marcorispoli/PCB301/(list of files, cad)

Other CAD files:
ESECUTIVI/PM22-301-0.dwg
LAYOUT/22-301-0.dwg
ESECUTIVI/PF22-301-0.dwg
ESECUTIVI/22-301-0.dwg
