marcorispoli/PCB301/ORCAD/SCH_301-0.pdf

0

0

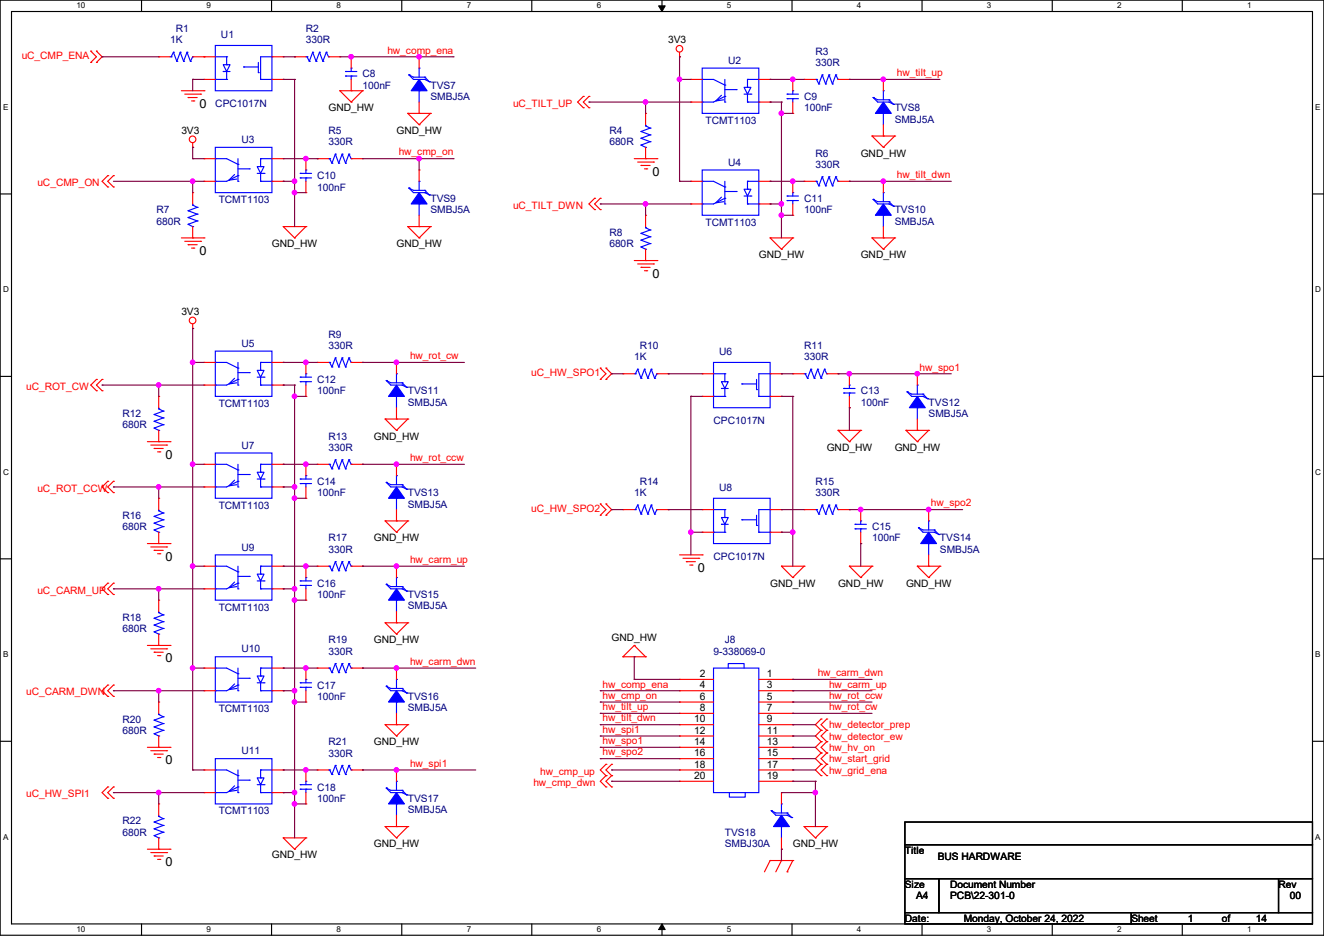
[picture p1: page 1]

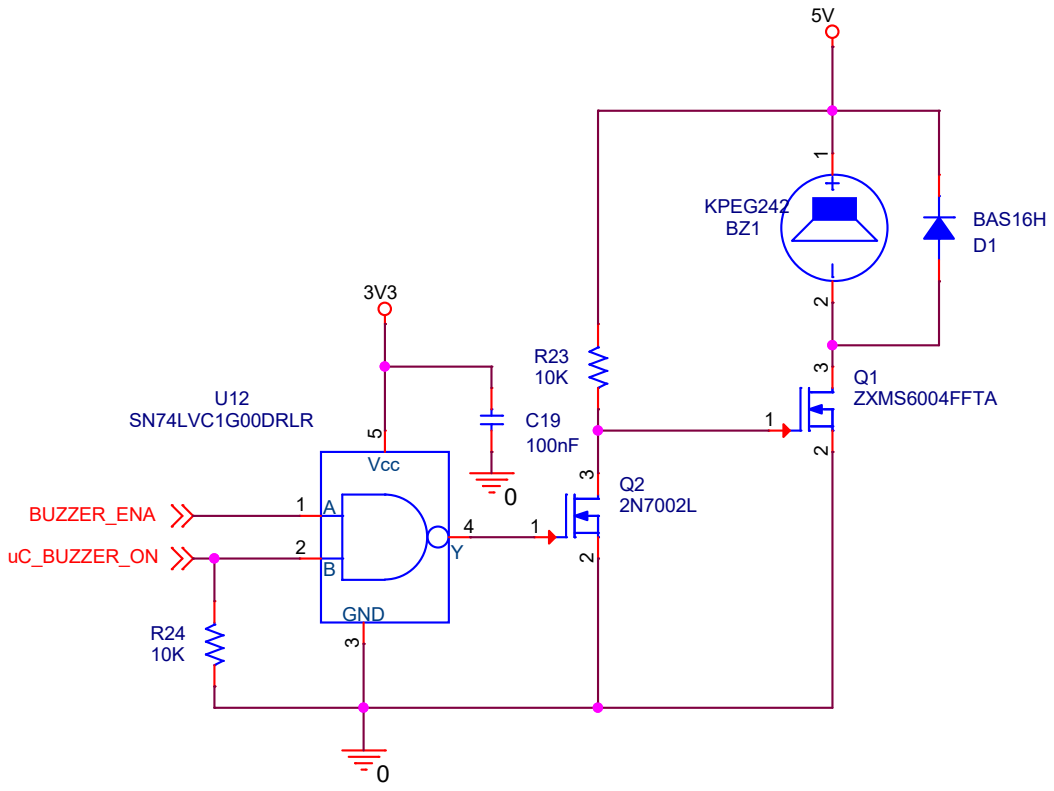
[picture p2: page 2]
BUZZER_ENA; uC_BUZZER_ON; Title; BUZZER; Monday, October 24, 2022; U12 SN74LVC1G00DRLR; 3 GND; Vcc⁵; ZXMS6004FFTA; BAS16H; KPEG242

0

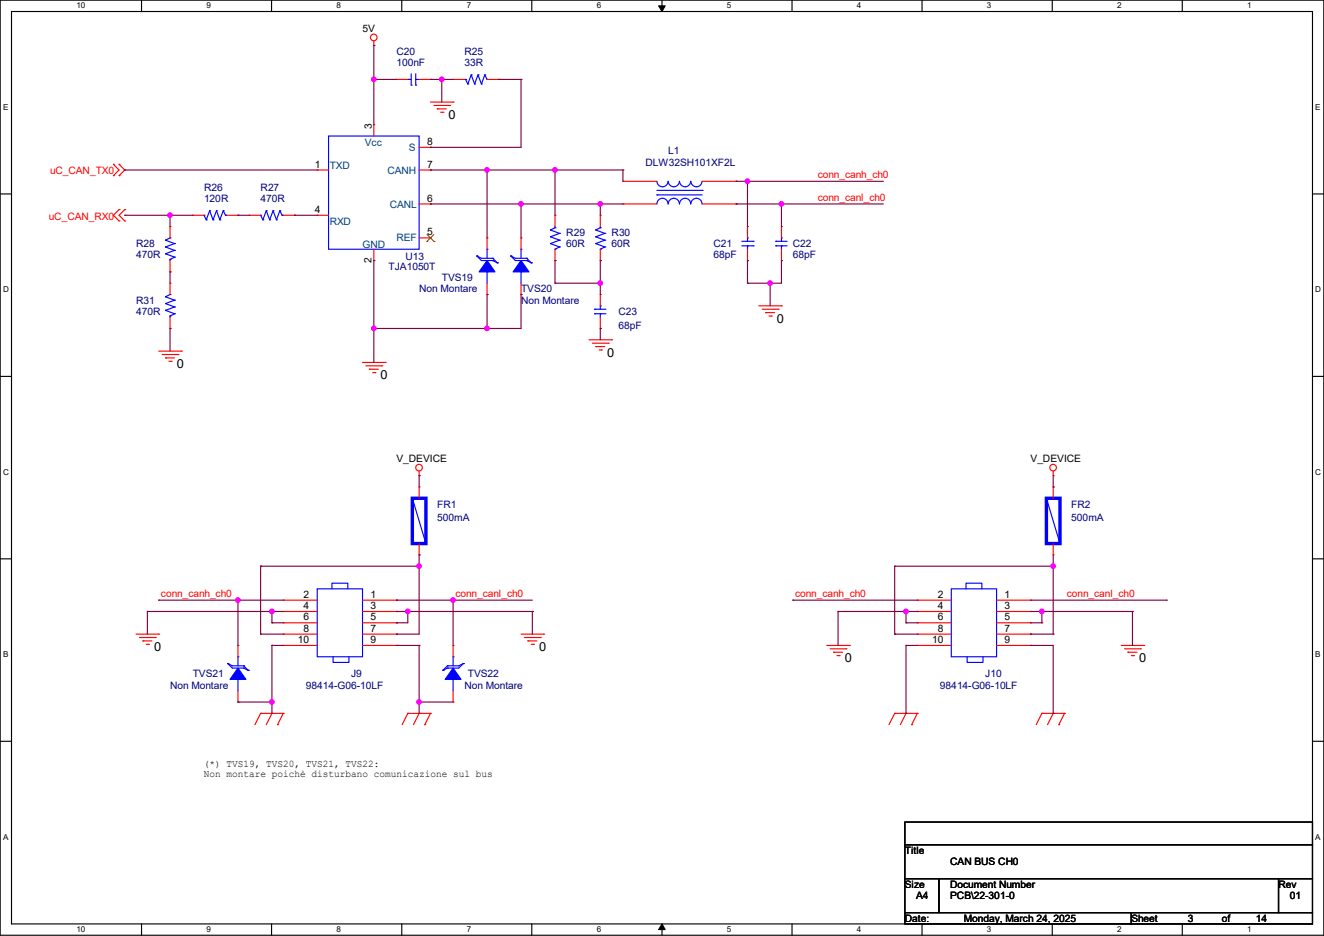
[picture p3: page 3]

Non montare poichè disturbano comunicazione sul bus

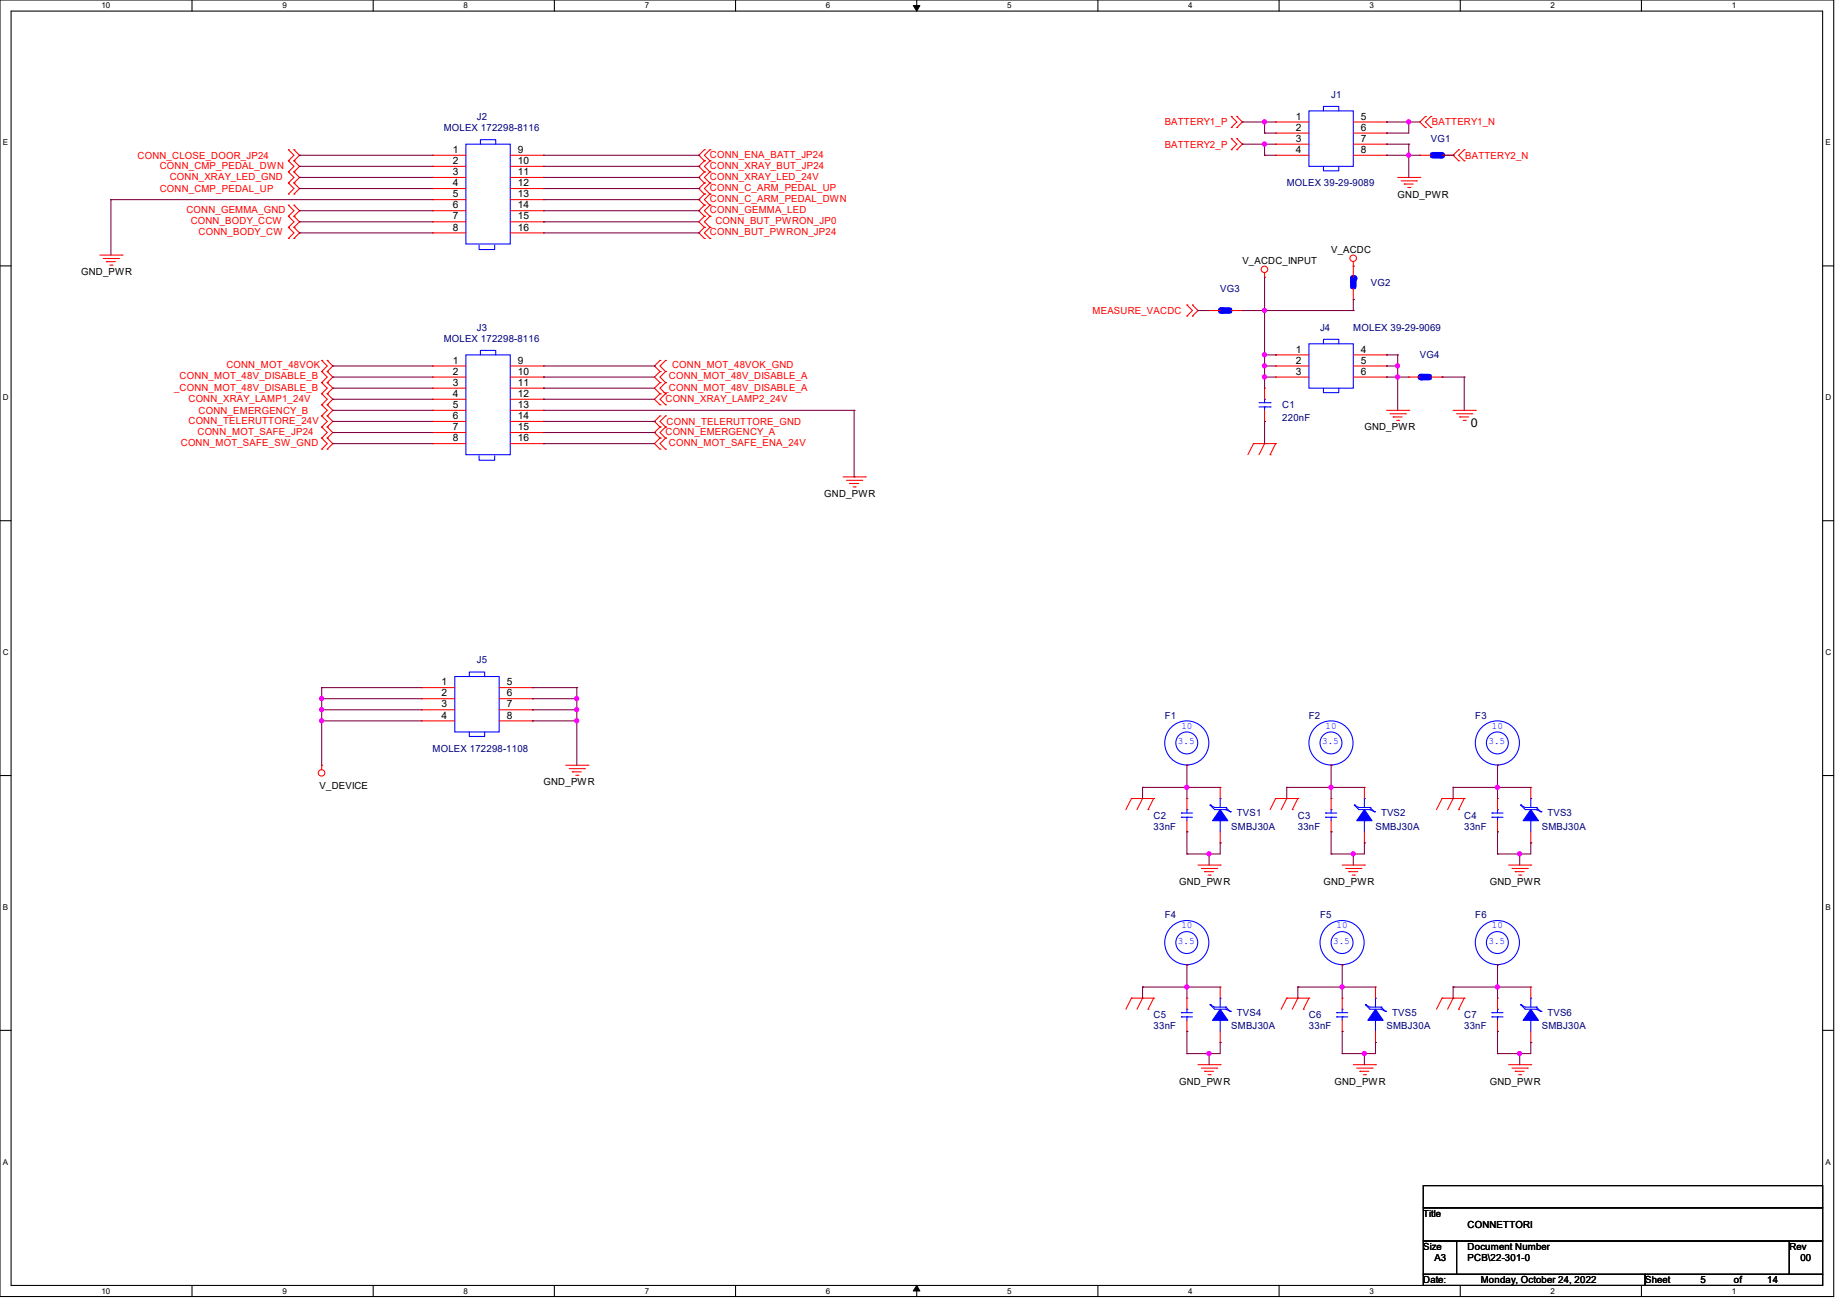
[picture p4: page 4]

0

det_ew prep | hv_on | start_grid | grid_ena | det_ew

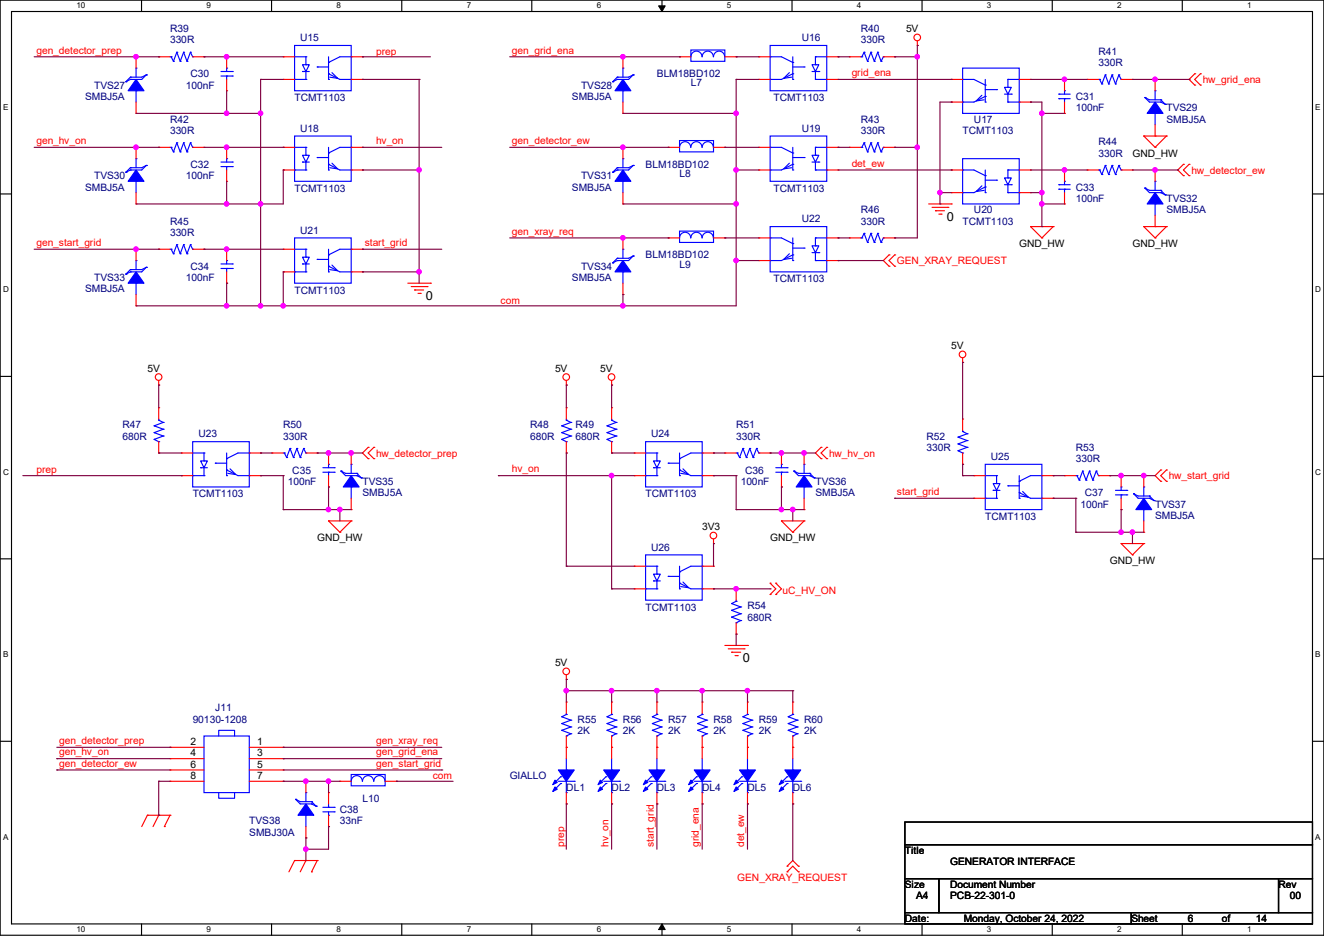
[picture p5: page 5]

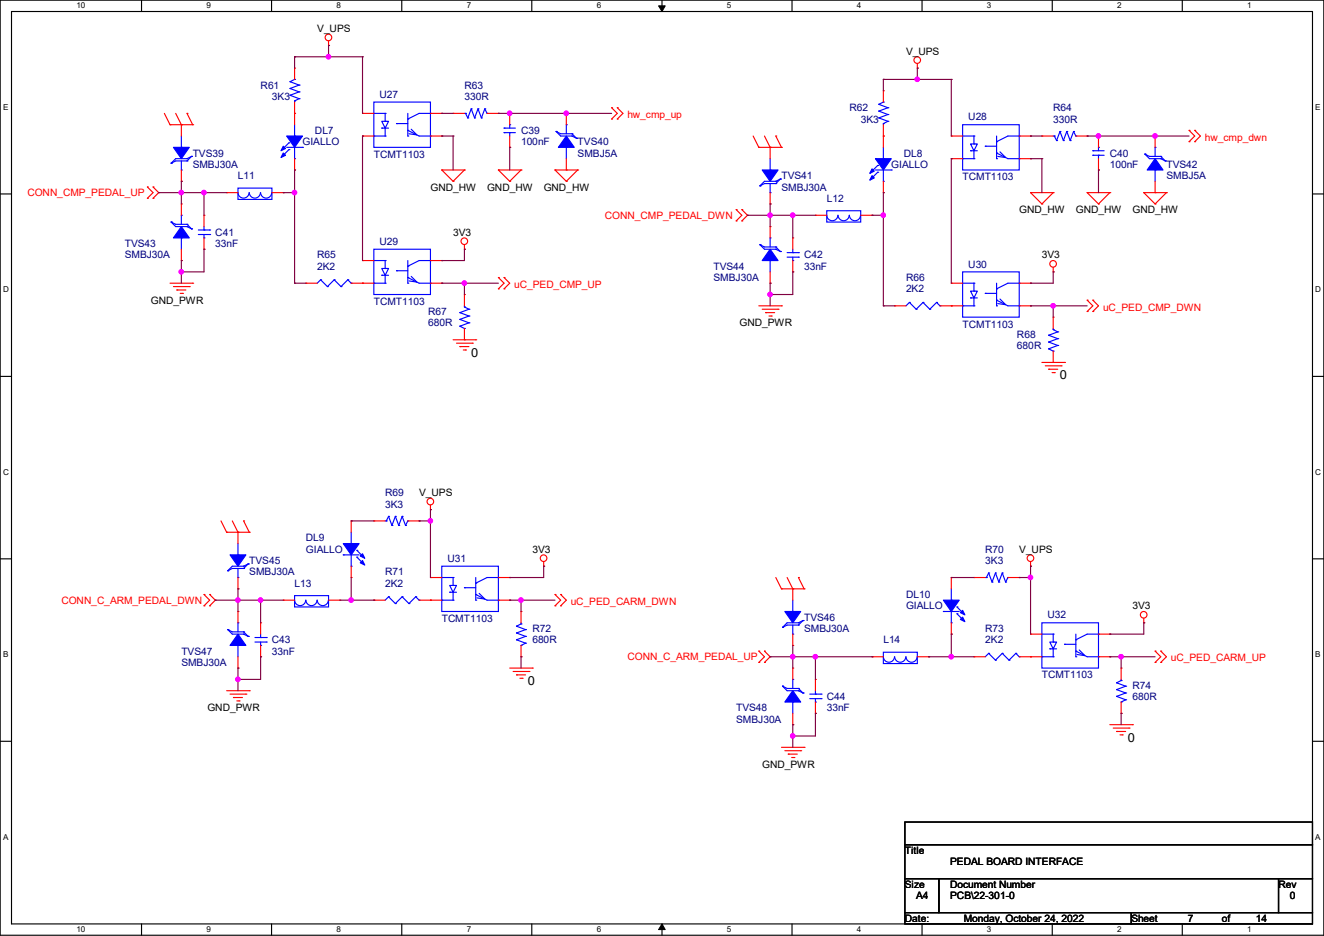
[picture p6: page 6]

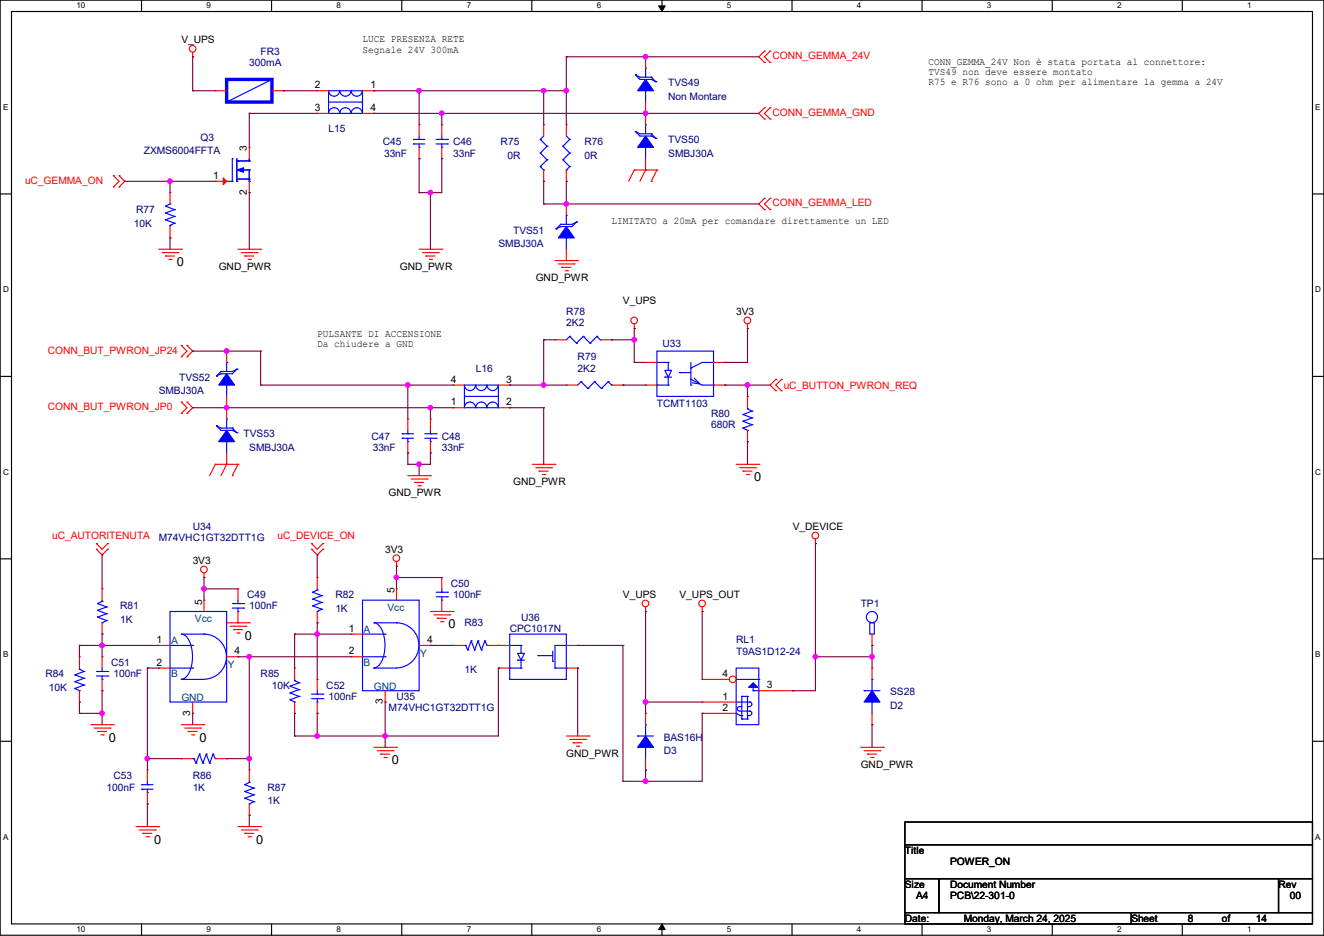
[picture p7: page 7]

CONN_GEMMA_24V Non è stata portata al connettore:
TVS49 non deve essere montato
R75 e R76 sono a 0 ohm per alimentare la gemma a 24V

LIMITATO a 20mA per comandare direttamente un LED

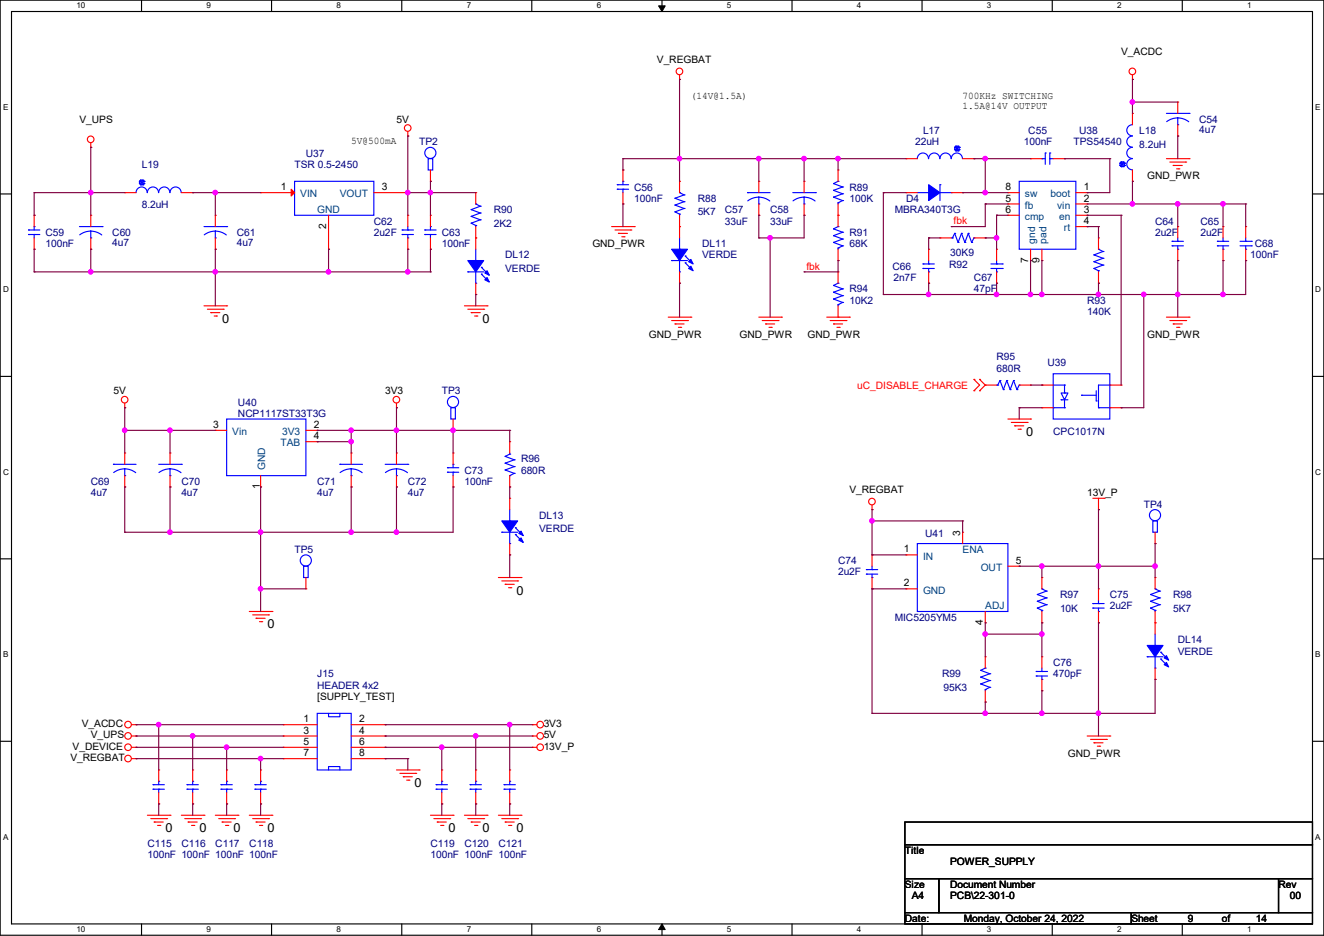
[picture p8: page 8]

0

0

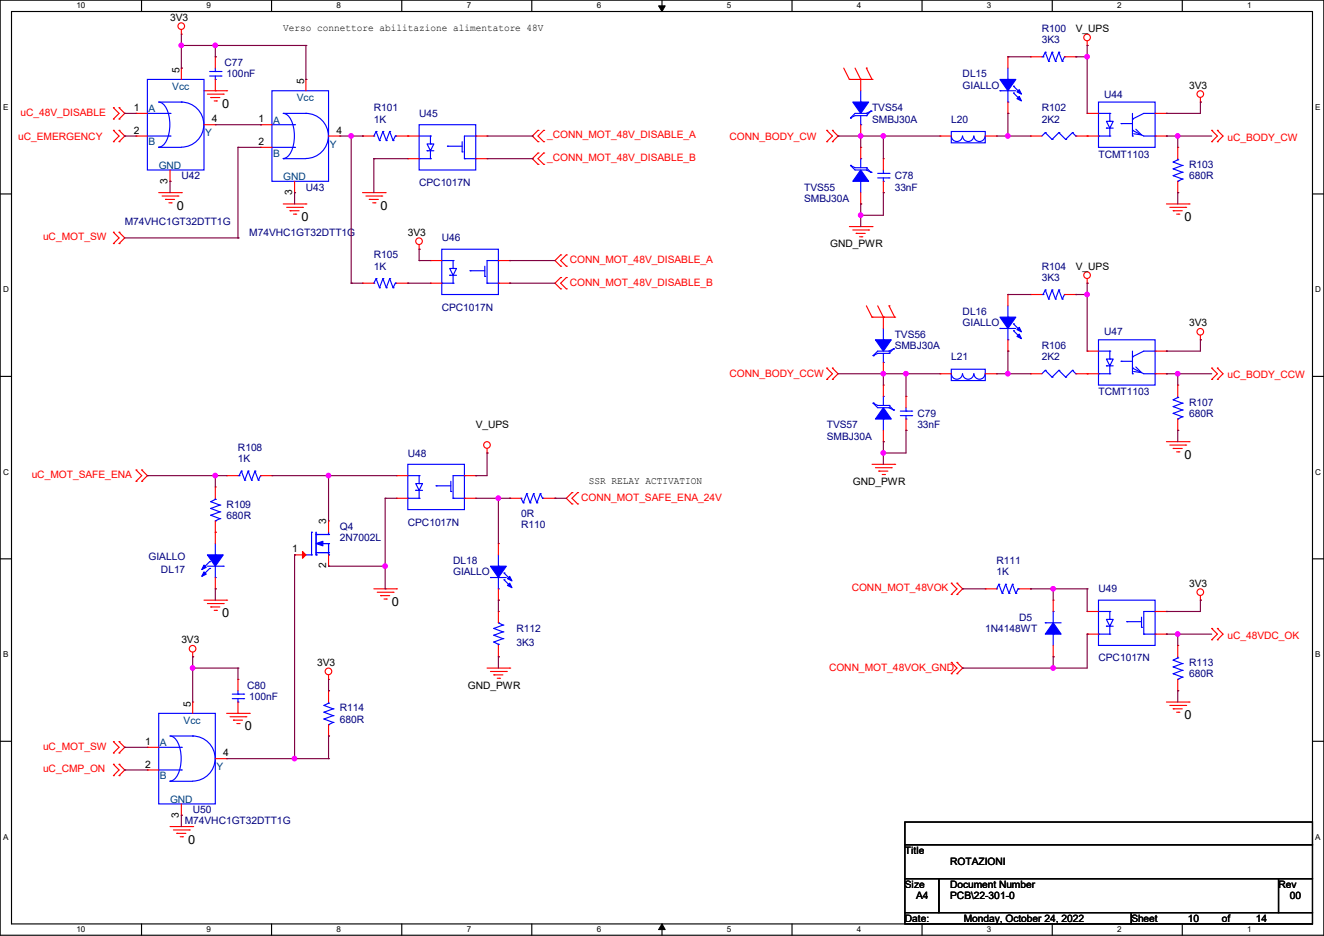
[picture p9: page 9]

Verso connettore abilitazione alimentatore 48V

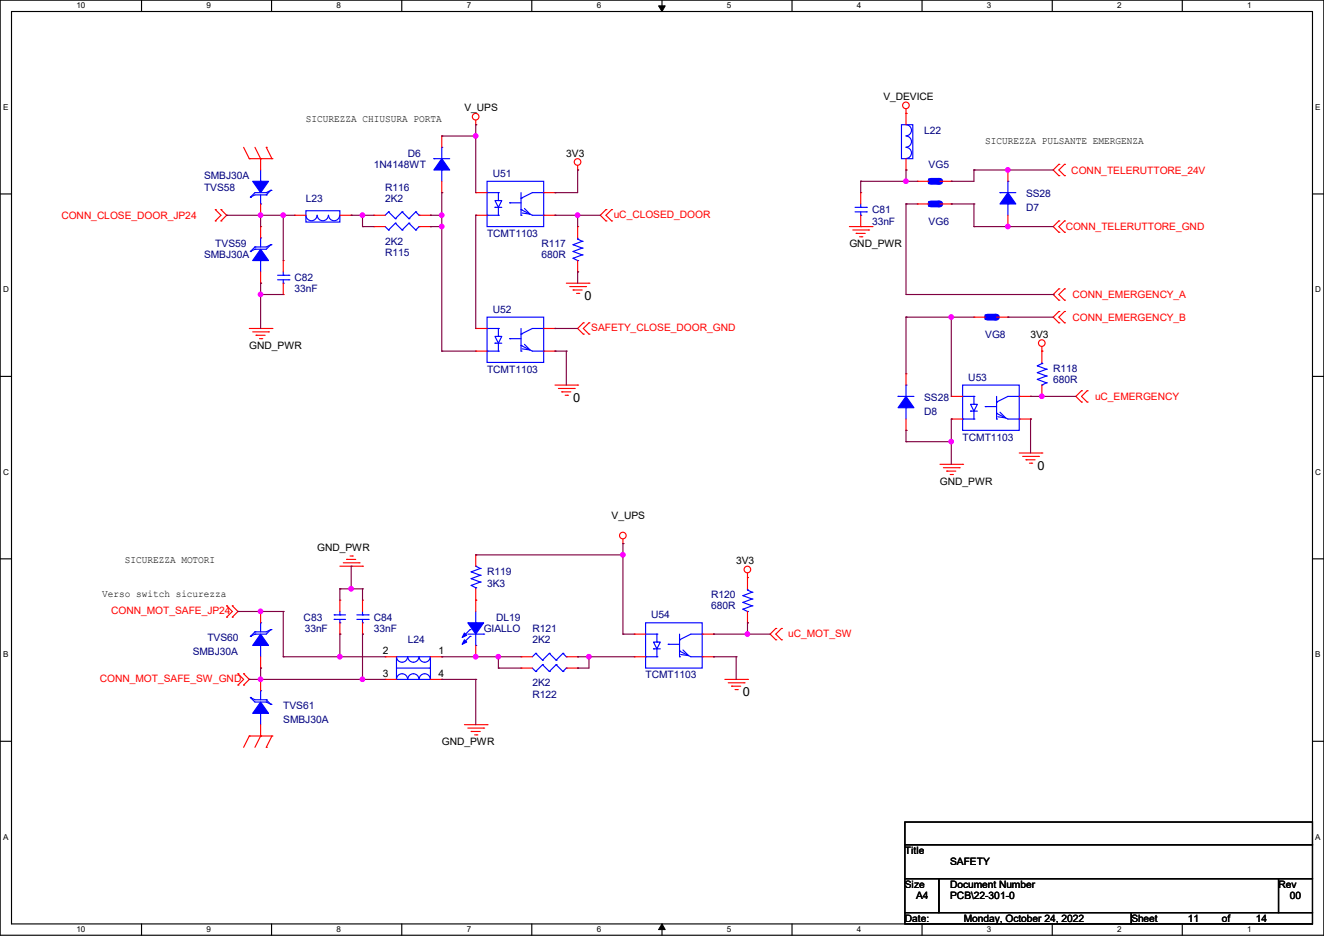
[picture p10: page 10]

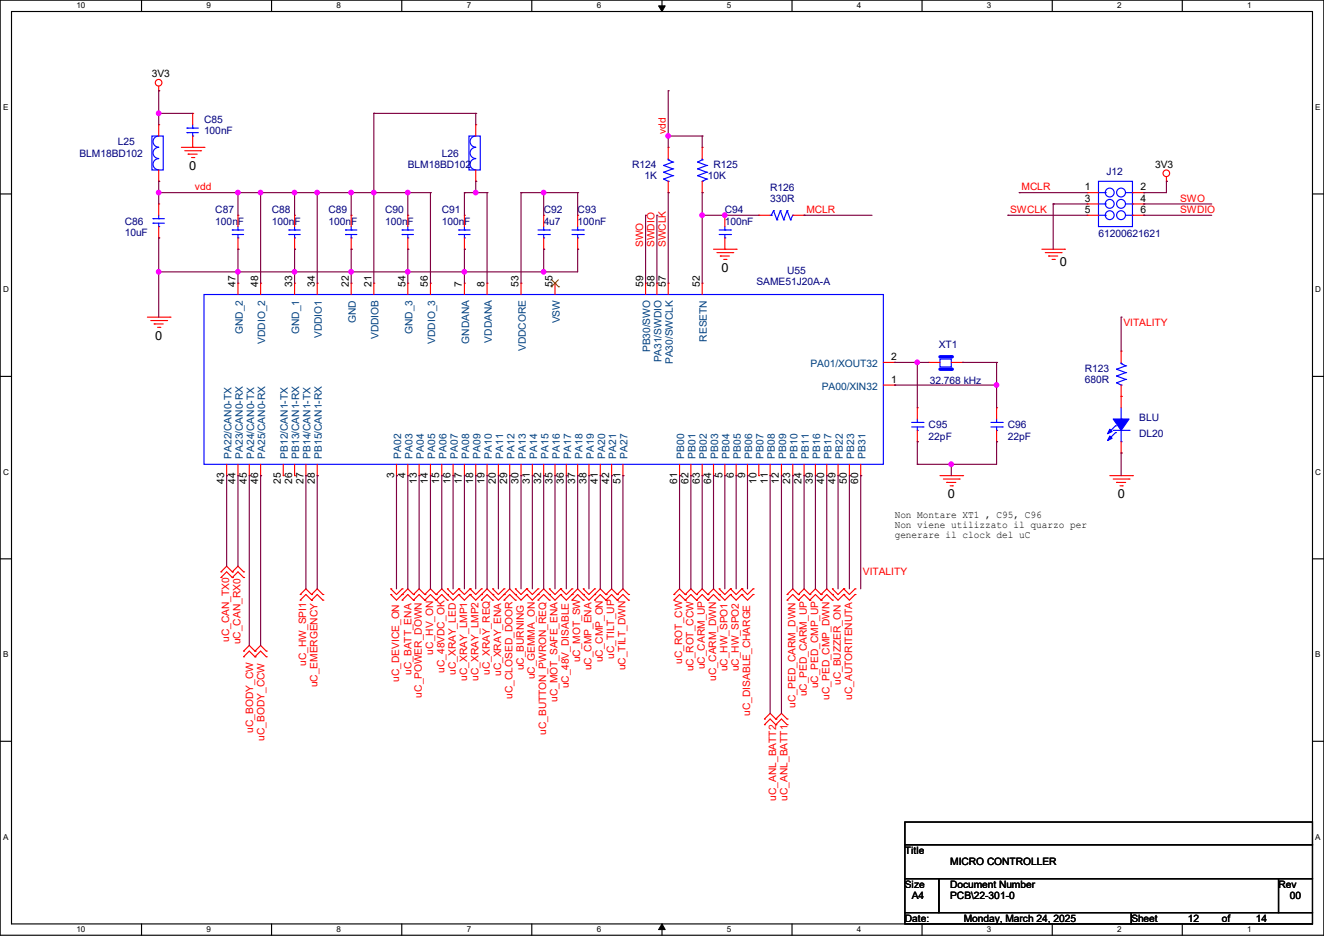
[picture p11: page 11]

9 PB07 10 PB08 11 PB09 12 PA04 13 PA05 14 PA06 15 PA07 16 PA08 17 PA09 18 PA10 19 PA11 20 VDDIOB 21 GND 22 PB10 23 PB11 24 PB12/CAN1-TX 25 PB13/CAN1-RX 26 PB14/CAN1-TX 27 PB15/CAN1-RX 28 PA12 29 PA13 30 PA14 31 PA15 32 GND_1 33 VDDIO1 34 PA16 35 PA17 36 PA18 37 PA19 38 PB16 39 PB17 40 PA20 41 PA21 42 PA22/CAN0-TX 43 PA23/CAN0-RX 44 PA24/CAN0-TX 45 PA25/CAN0-RX 46 GND_2 47 VDDIO_2 48 PB22 49 PB23 50 PA27 51 RESETN 52 VDDCORE 53 GND_3 54 VSW 55 VDDIO_3 56 PA30/SWCLK 57 PA31/SWDIO 58 PB30/SWO 59 PB31 60 PB00 61 PB01 62 PB02 63 PB03 64

Non Montare XT1 , C95, C96
Non viene utilizzato il quarzo per
generare il clock del uC

# 25A 500mA

25A 25A

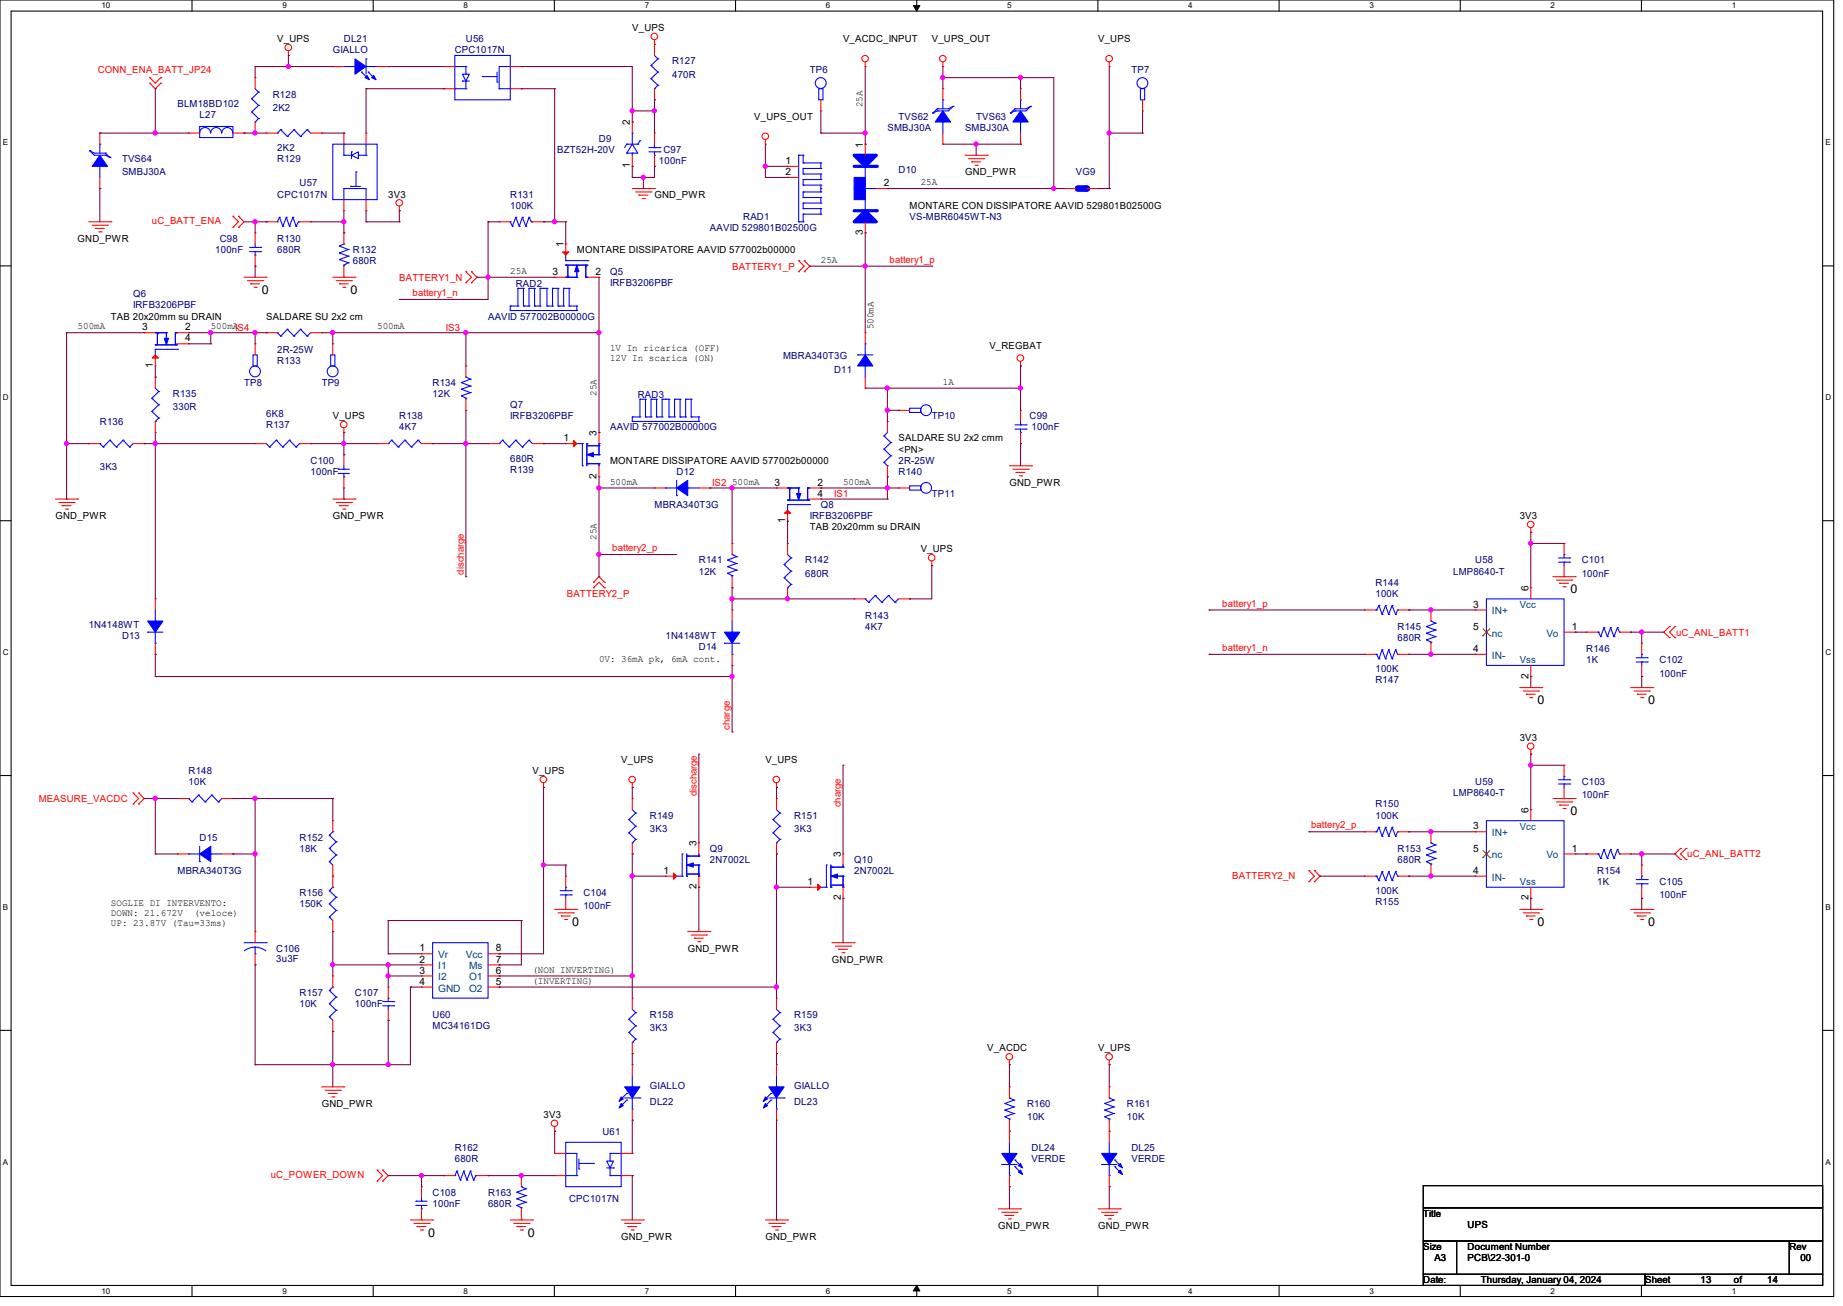
[picture p12: page 12]

D10VS-MBR6045WT-N3 MONTARE CON DISSIPATORE AAVID 529801B02500G

<PN> SALDARE SU 2x2 cmm

0

0

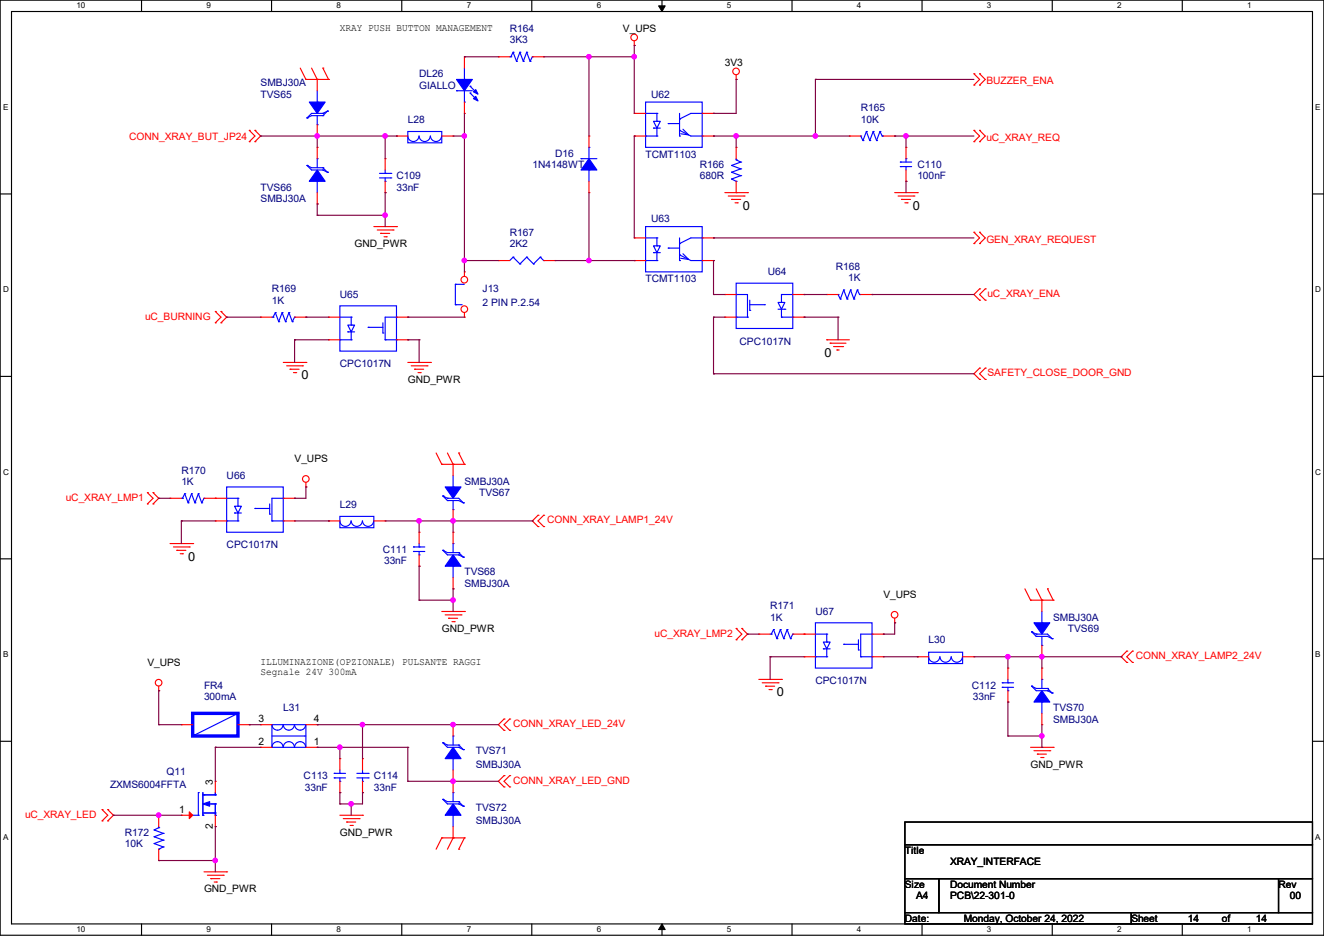
[picture p13: page 13]

XRAY PUSH BUTTON MANAGEMENT

ILLUMINAZIONE(OPZIONALE) PULSANTE RAGGI
Segnale 24V 300mA
