marcorispoli/PCB301/ESECUTIVI/PF22-301-0.pdf

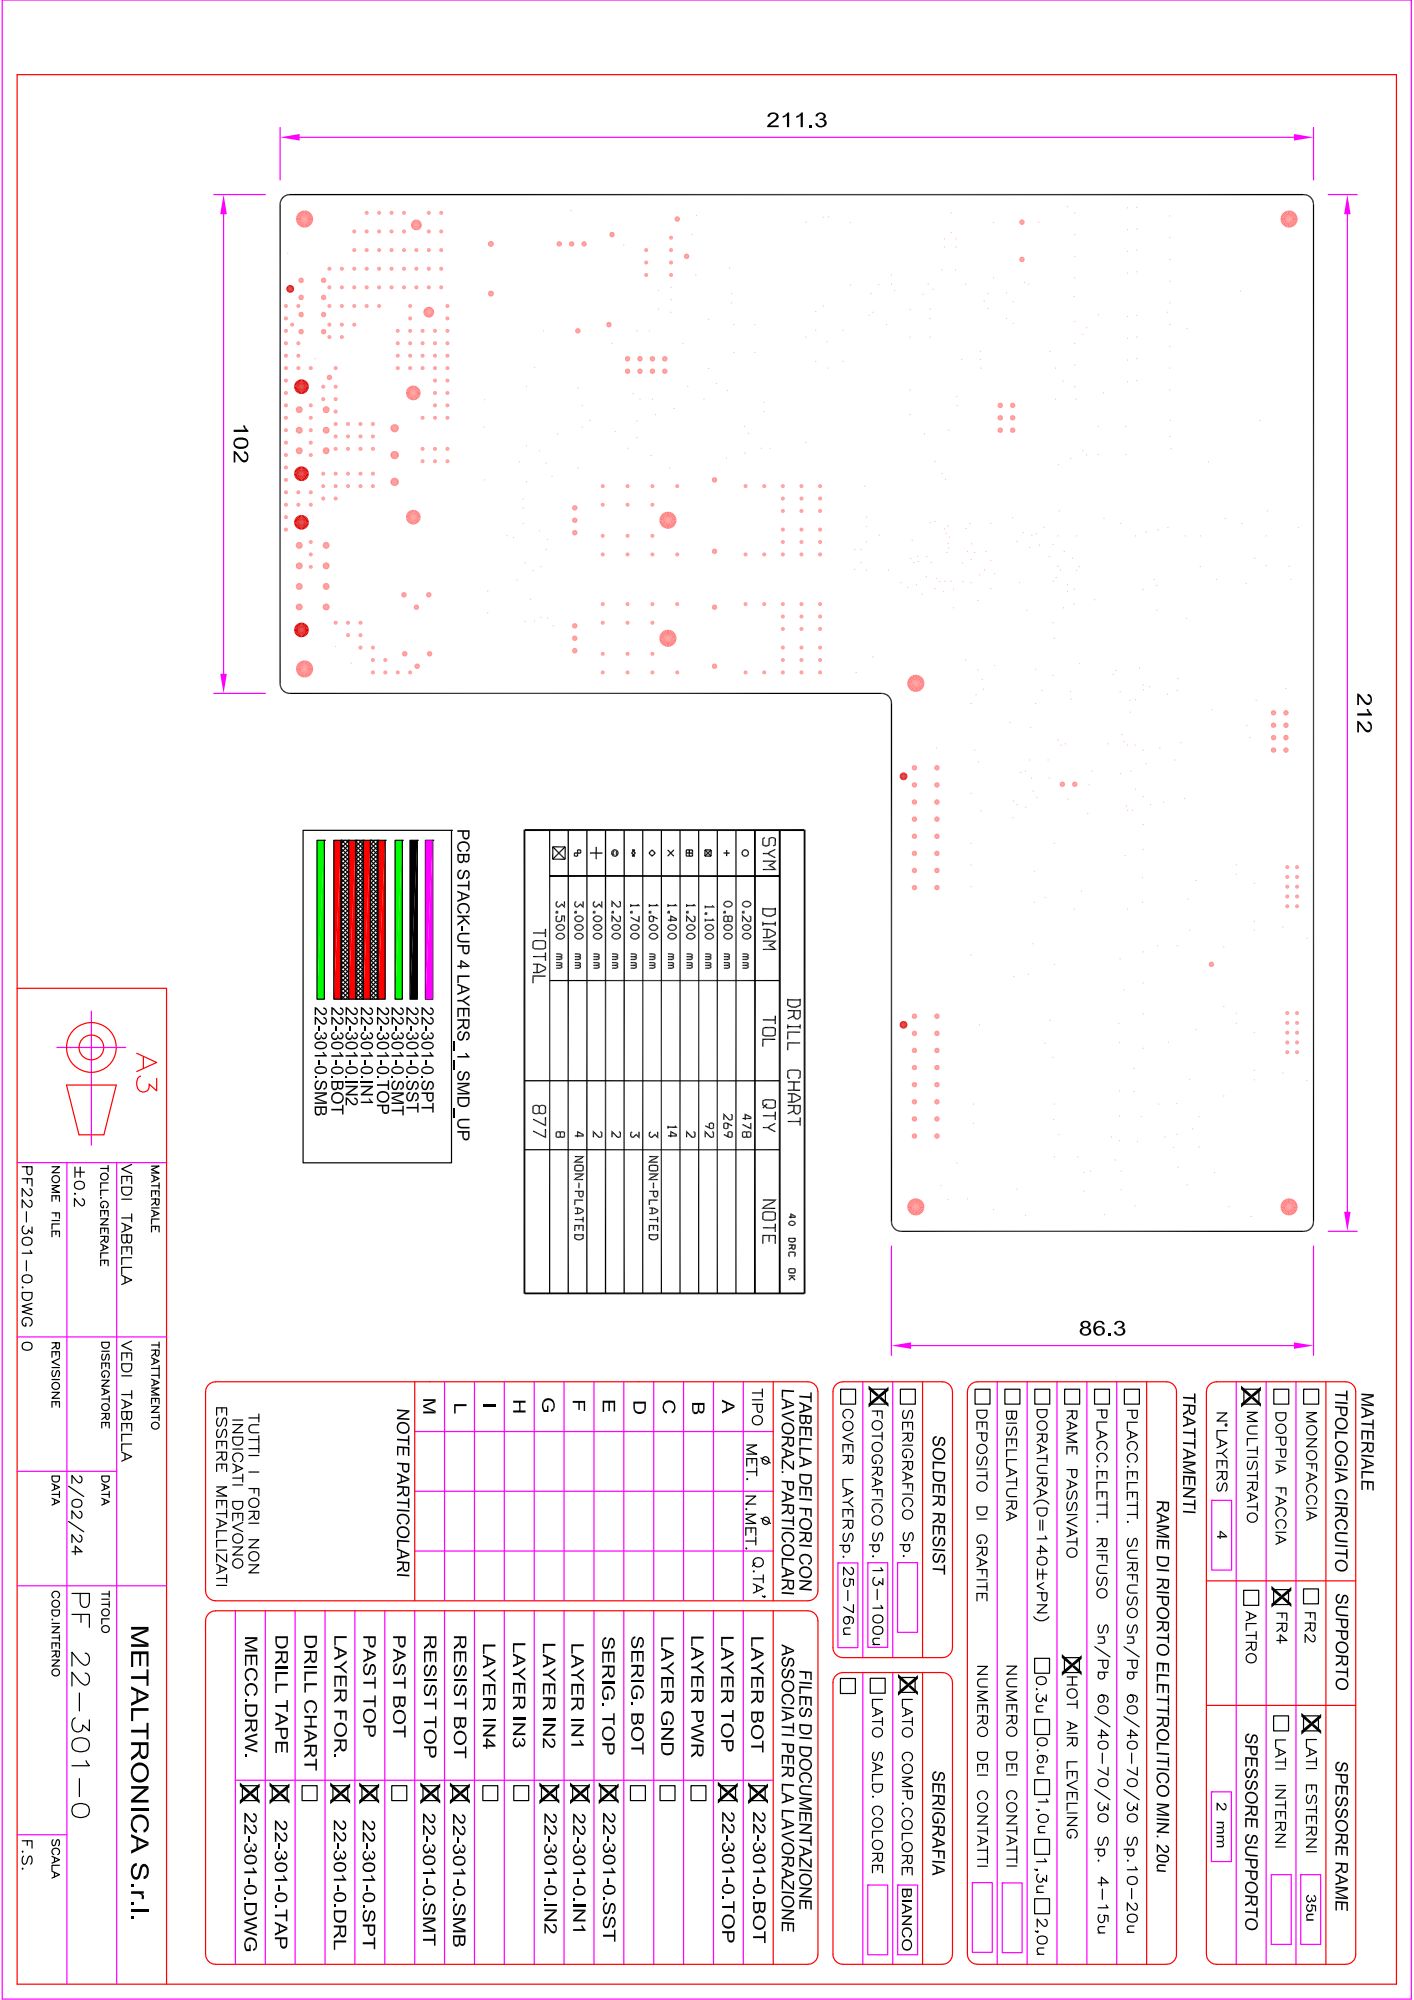
[picture p14: page 1]
