marcorispoli/PCB301/ESECUTIVI/PM22-301-0.pdf

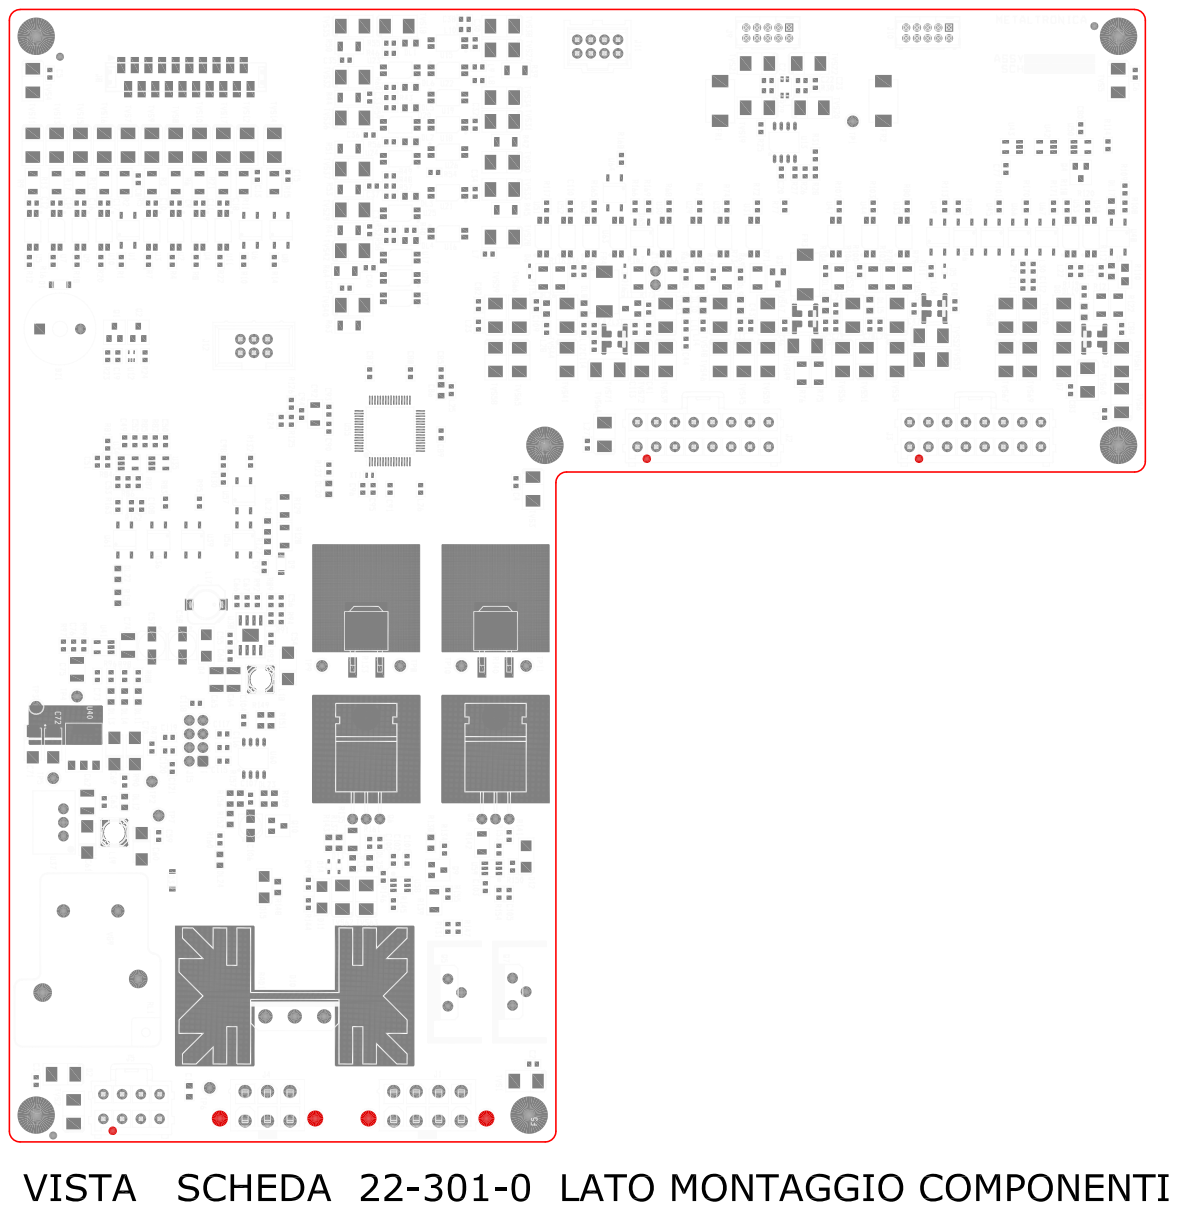
[picture p15: page 1]
