marcorispoli/PCB301/(list of files, drawings)

Other design files:
ORCAD/22-301-0.DSN
ORCAD/22-301-0.opj
