marcorispoli/PCB301/(commit log)

2022-09-05 Revisione iniziale
    [LAYOUT-22-301.opj, Layout-22-301.DSN, PCB-22-301-0.DSN, PCB-22-301-0.opj]
2022-09-05 Generati schematico e lista parti
    [22-301-0.xlsx, PCB-22-301-0.opj]
2022-09-05 Consegna Osvaldo del 29-08-2022
    [22-301-0.DSN, 22-301-0.opj, 22-301-0.xlsx, PCB-22-301-0.DSN, PCB-22-301-0.opj]
2022-09-05 Generata BOM testuale per confronto
    [22-301-0.opj]
2022-09-05 Inserito il connettore J15 per l'accesso alle alimentazioni della scheda
    Nella pagina POWER_SUPPLY inseriti:
    - J15: header 4x2
    - C115-C121: 100nF, SMD0603
    [22-301-0.DSN, 22-301-0.opj, 22-301-0.xlsx]
2022-09-21 Esecutivi completi per release 1.0 Materiale inviato a Soldà per prototipazione
    [22-301-0.DSN, 22-301-0.dwg, 22-301-0.opj, 22-301-0.xlsx, LP22-301-0.xlsx, PF22-301-0.dwg, PM22-301-0.dwg]
2022-09-21 Aggiornato piano foratura per portare la scheda a 2mm di spessore
    [PF22-301-0.dwg]
2023-12-13 Modificato schema per correzione can bus bridge
    Deve ancora essere masterizzato
    [22-301-0.DSN, 22-301-0.opj]
2024-01-04 Sostituito PN MOSFET PSN con IRF
    [22-301-0.DSN, 22-301-0.opj]
2024-02-05 Effettuato lo sbroglio per le modifiche apportate
    [22-301-0.DSN, 22-301-0.dwg, 22-301-0.opj, LAYOUT-22-301.opj, LP22-301-0.xlsx, Layout-22-301.DSN, PF22-301-0.dwg, PM22-301-0.dwg]
2025-03-24 RELEASE 0: Modificato schematico e lista parti per aggiornare i componenti da non montare e commenti a futura memoria.
    [22-301-0.DSN, 22-301-0.opj, LP22-301-0.xlsx]
